bmoniey/dvox/docs/pics/IMG_2439.JPG

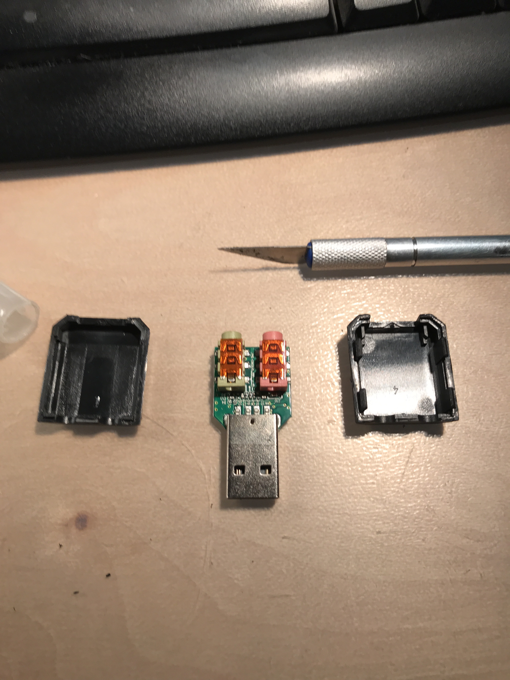
docs/pics/IMG_2439.JPG
