bmoniey/dvox/docs/pics/IMG_2547.JPG

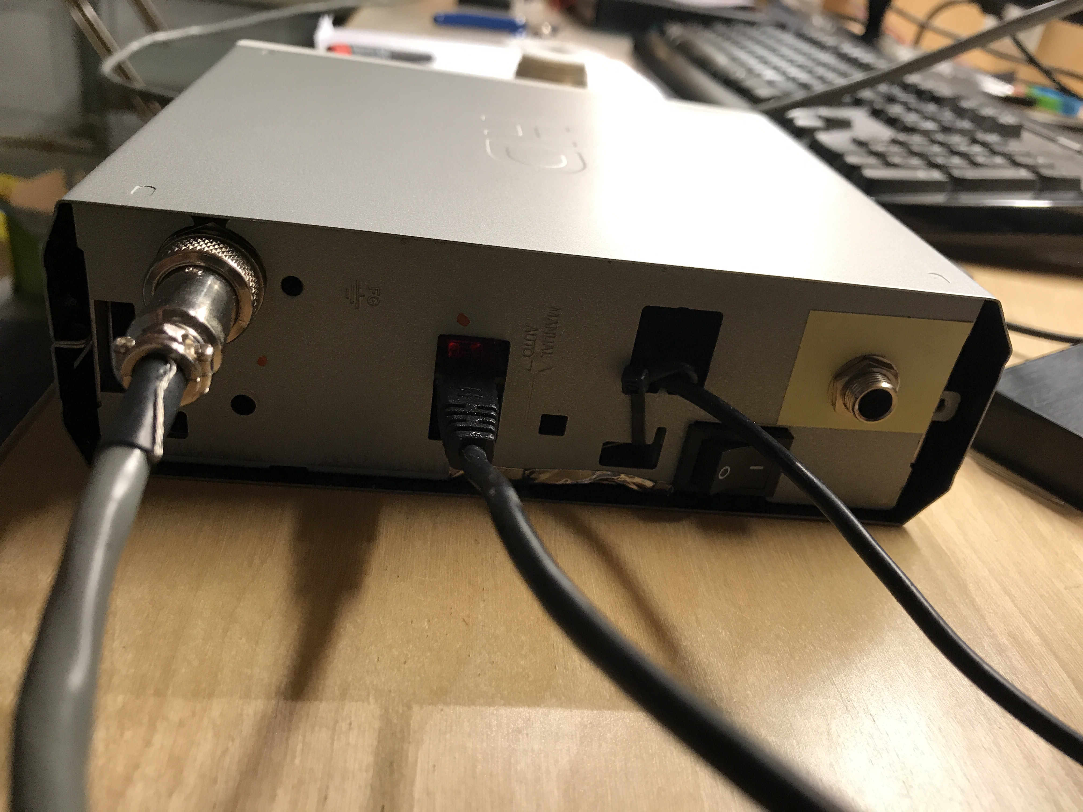
docs/pics/IMG_2547.JPG
