bmoniey/dvox/docs/pics/ft8 japan screen.jpg

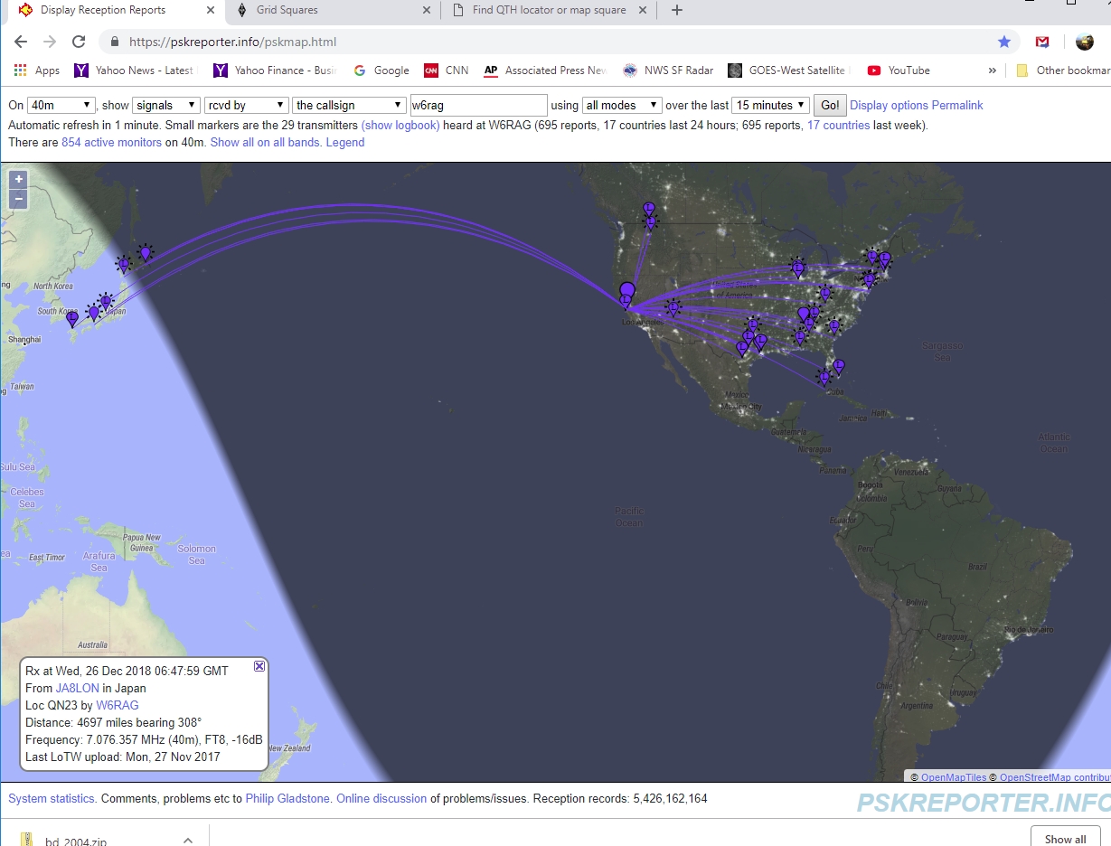
docs/pics/ft8 japan screen.jpg
