bmoniey/dvox/docs/pics/ft8 screen.jpg

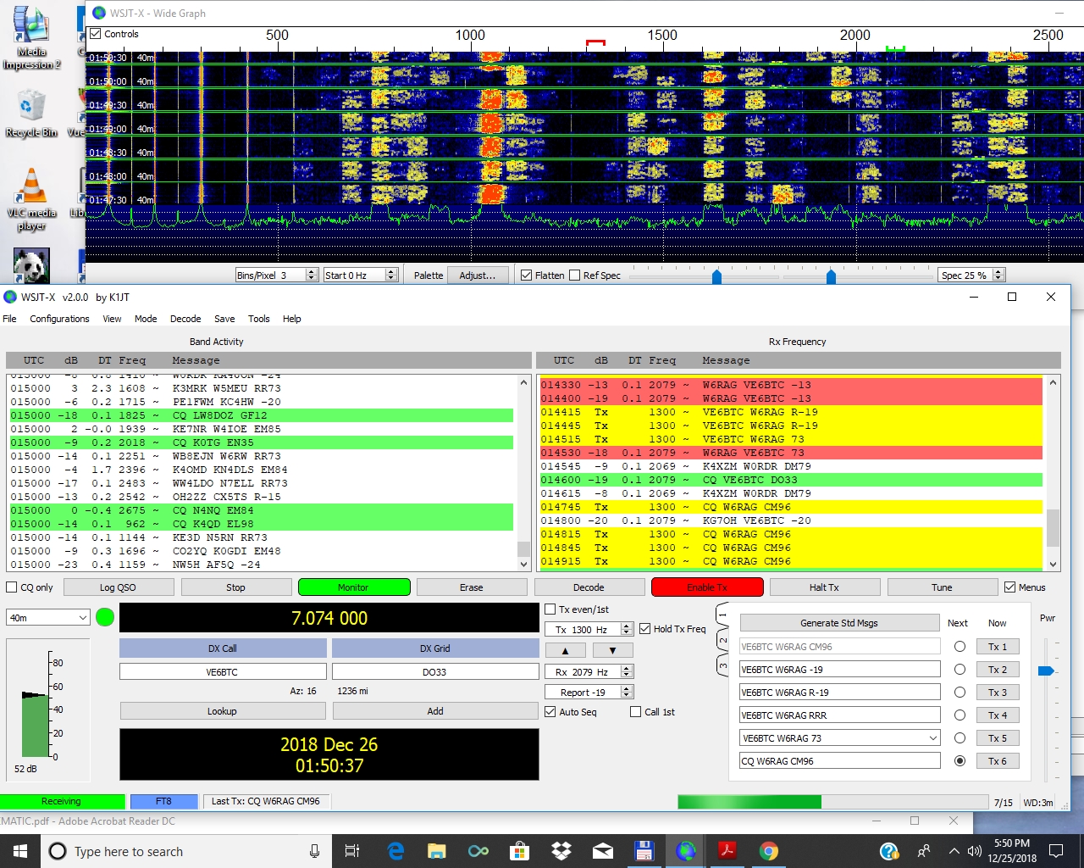
docs/pics/ft8 screen.jpg
