bmoniey/dvox/docs/pics/IMG_2438.JPG

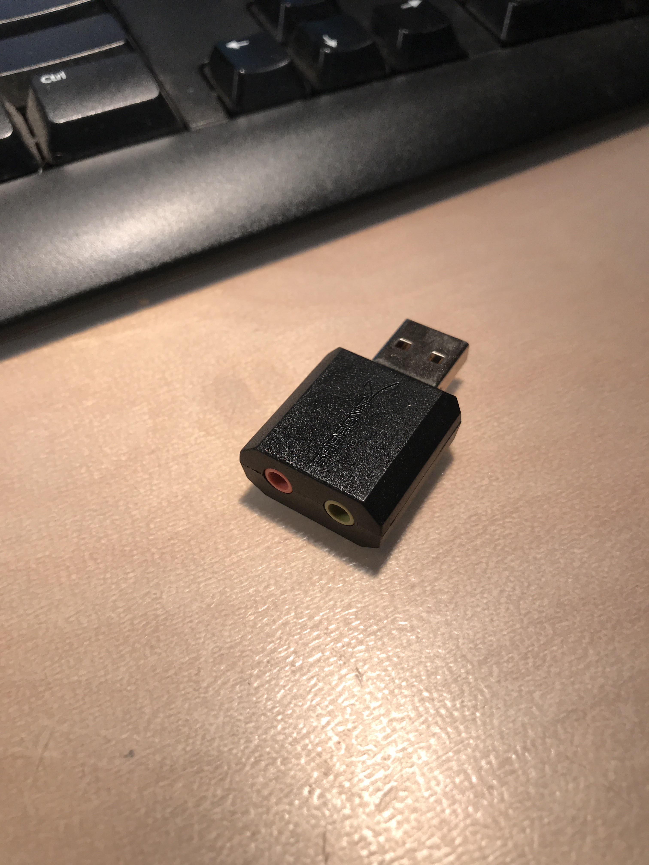
docs/pics/IMG_2438.JPG
