bmoniey/dvox/docs/pics/IMG_2440.JPG

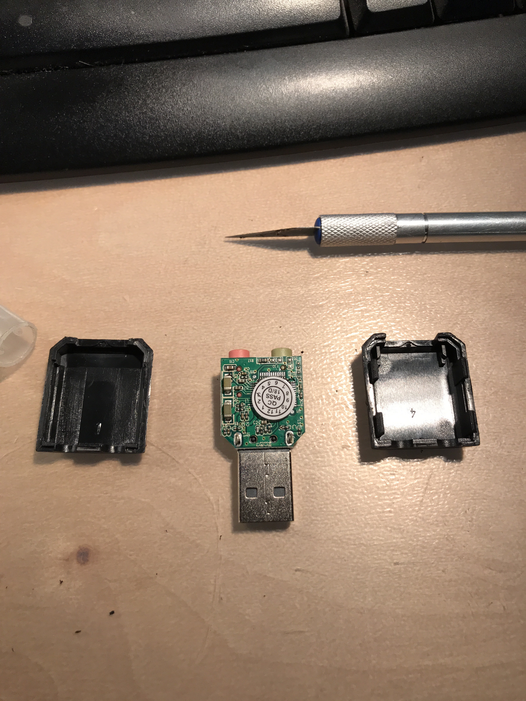
docs/pics/IMG_2440.JPG
