bmoniey/dvox/docs/pics/IMG_2538.JPG

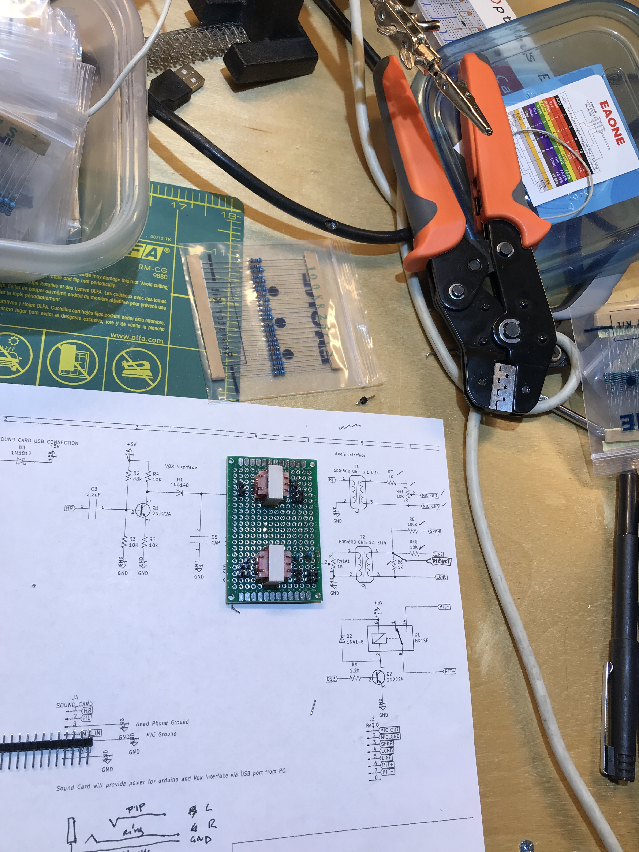
docs/pics/IMG_2538.JPG
