bmoniey/dvox/docs/pics/IMG_2539.JPG

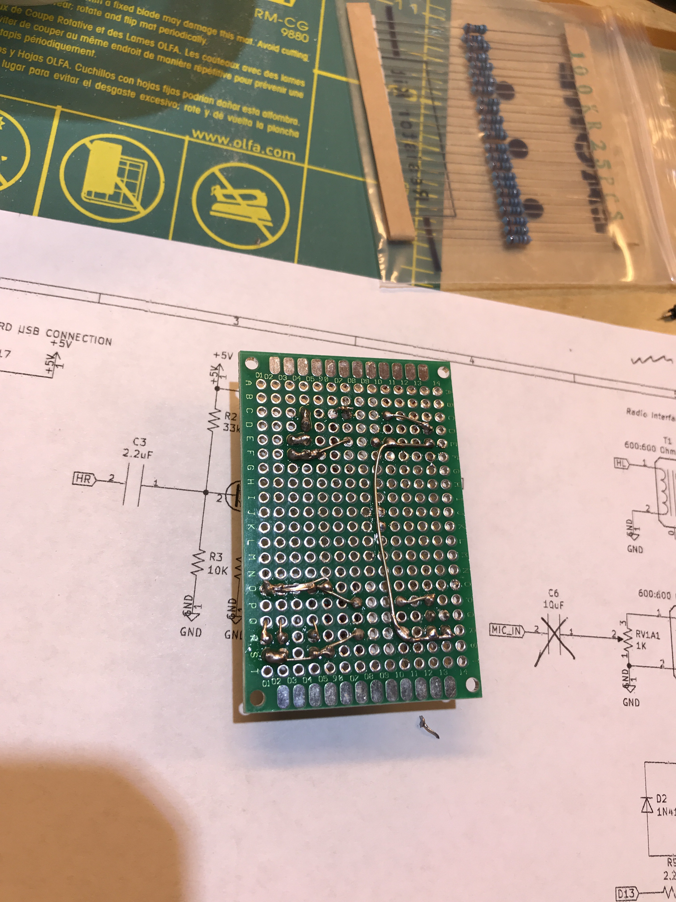
docs/pics/IMG_2539.JPG
