bmoniey/dvox/docs/pics/IMG_2540.JPG

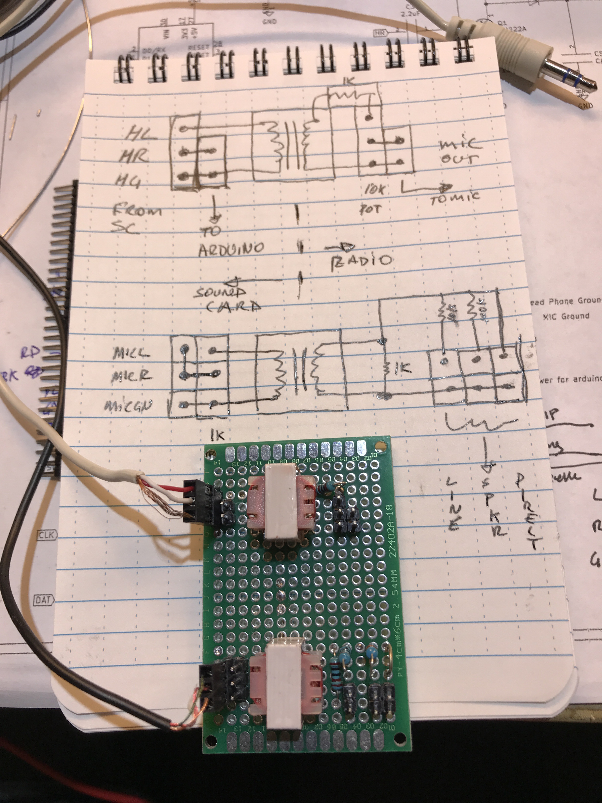
docs/pics/IMG_2540.JPG
