bmoniey/dvox/docs/pics/IMG_2546.JPG

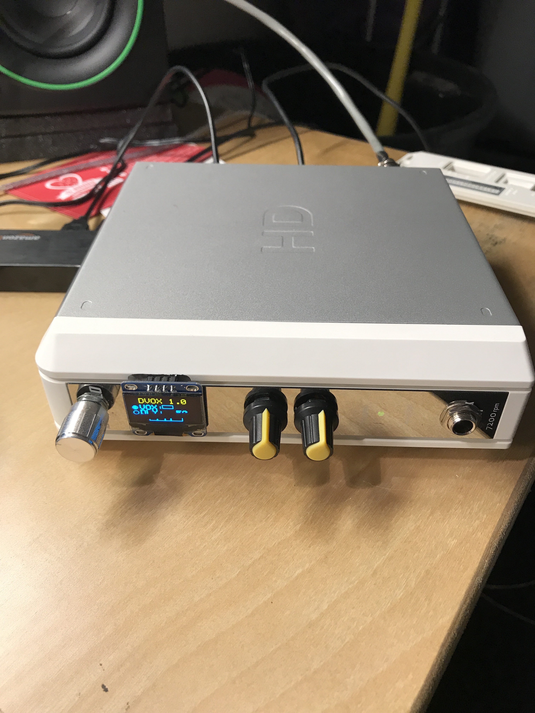
docs/pics/IMG_2546.JPG
