bmoniey/dvox/docs/pics/IMG_2548.JPG

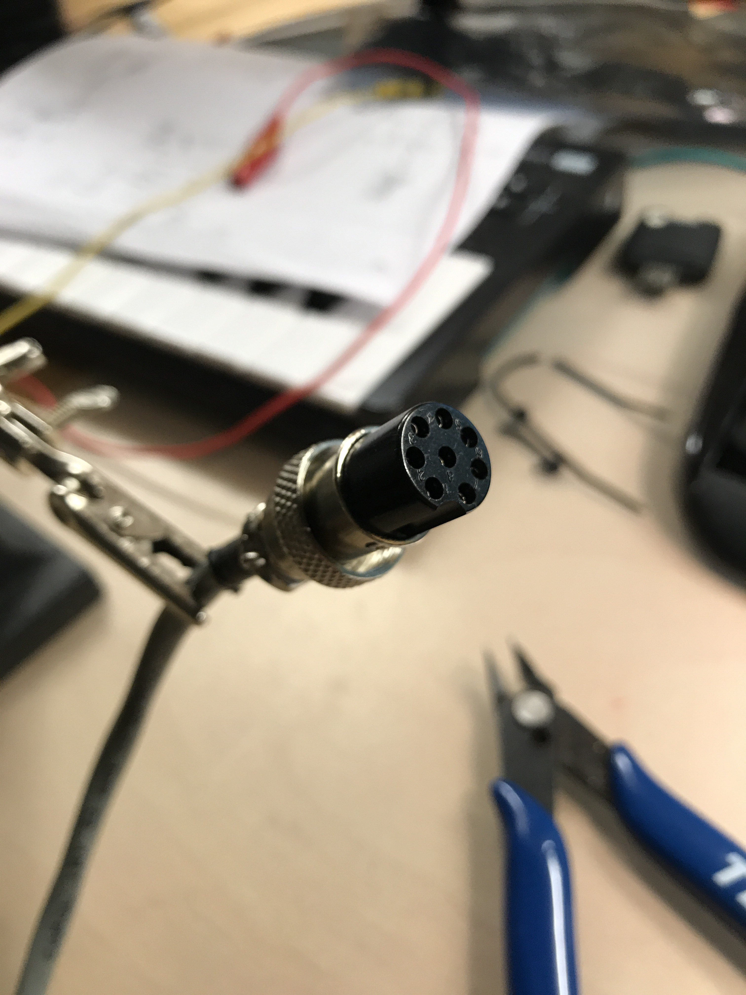
docs/pics/IMG_2548.JPG
