bmoniey/dvox/docs/pics/IMG_2549.JPG

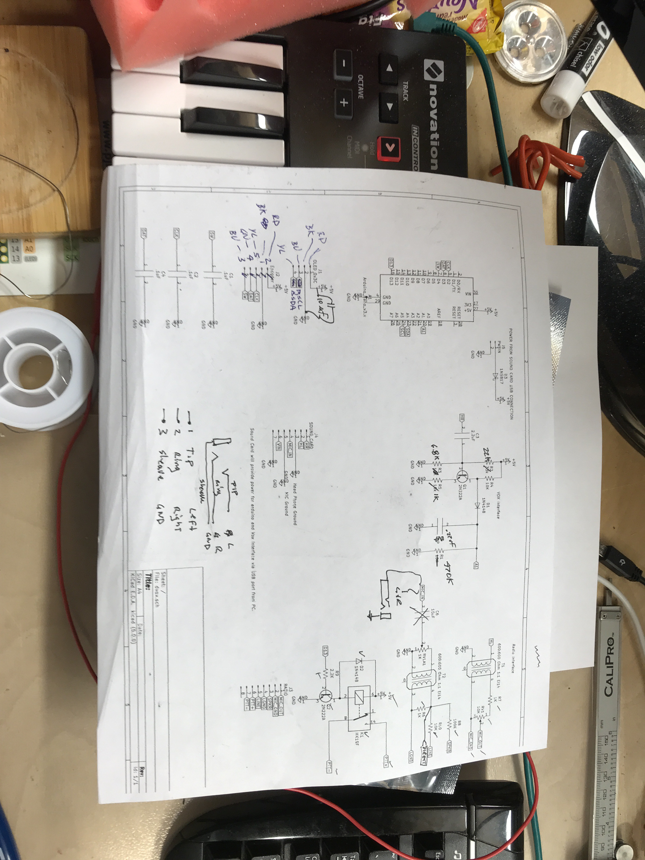
docs/pics/IMG_2549.JPG
