bmoniey/dvox/docs/pics/IMG_2567.JPG

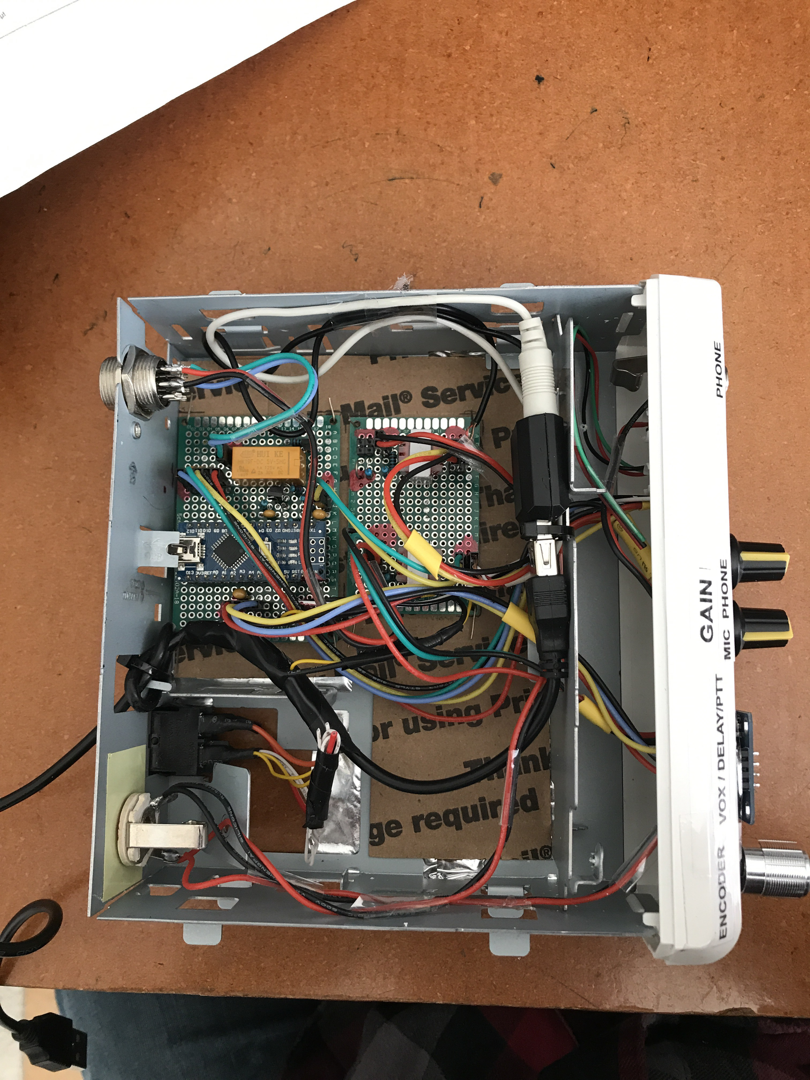
docs/pics/IMG_2567.JPG
