bmoniey/dvox/docs/pics/IMG_20181228_192853699.jpg

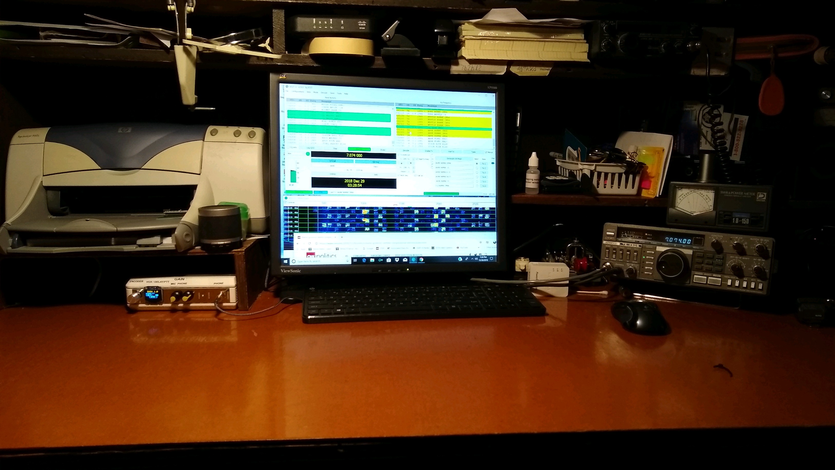
docs/pics/IMG_20181228_192853699.jpg
