bmoniey/dvox/docs/pics/n6nme ft8 Fiji.jpg

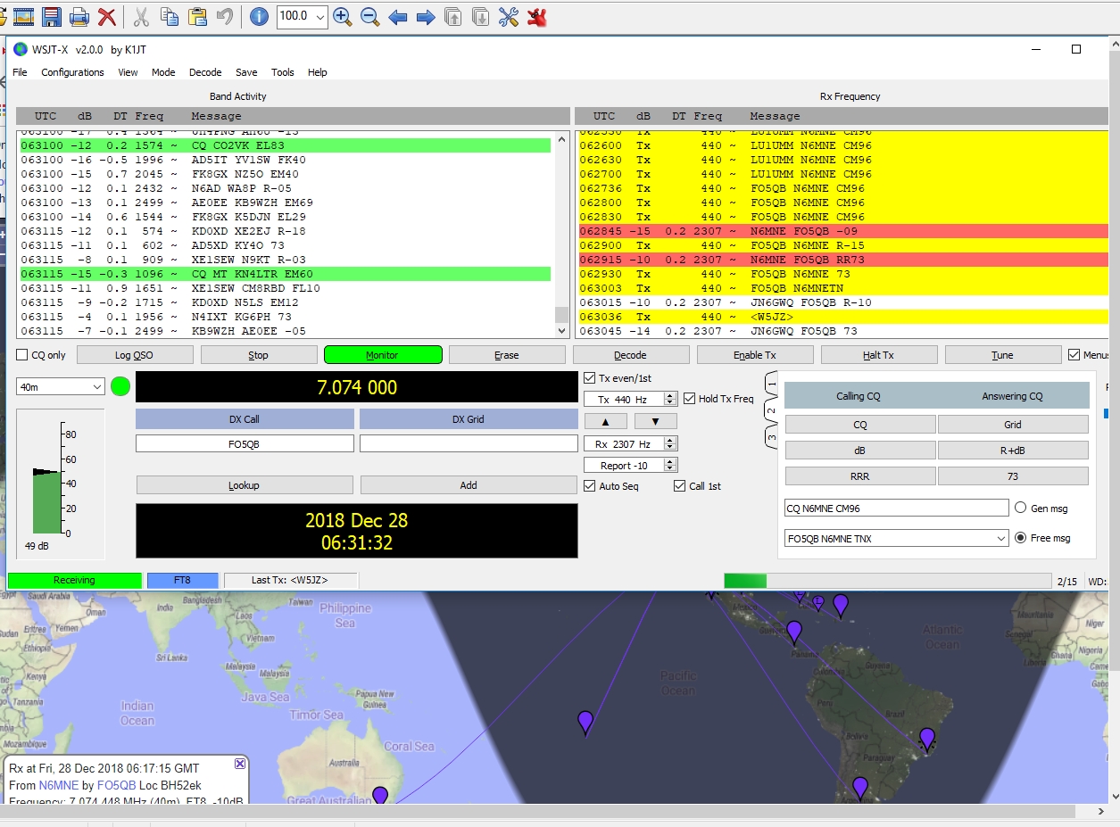
docs/pics/n6nme ft8 Fiji.jpg
