bmoniey/dvox/docs/pics/n6nme ft8.jpg

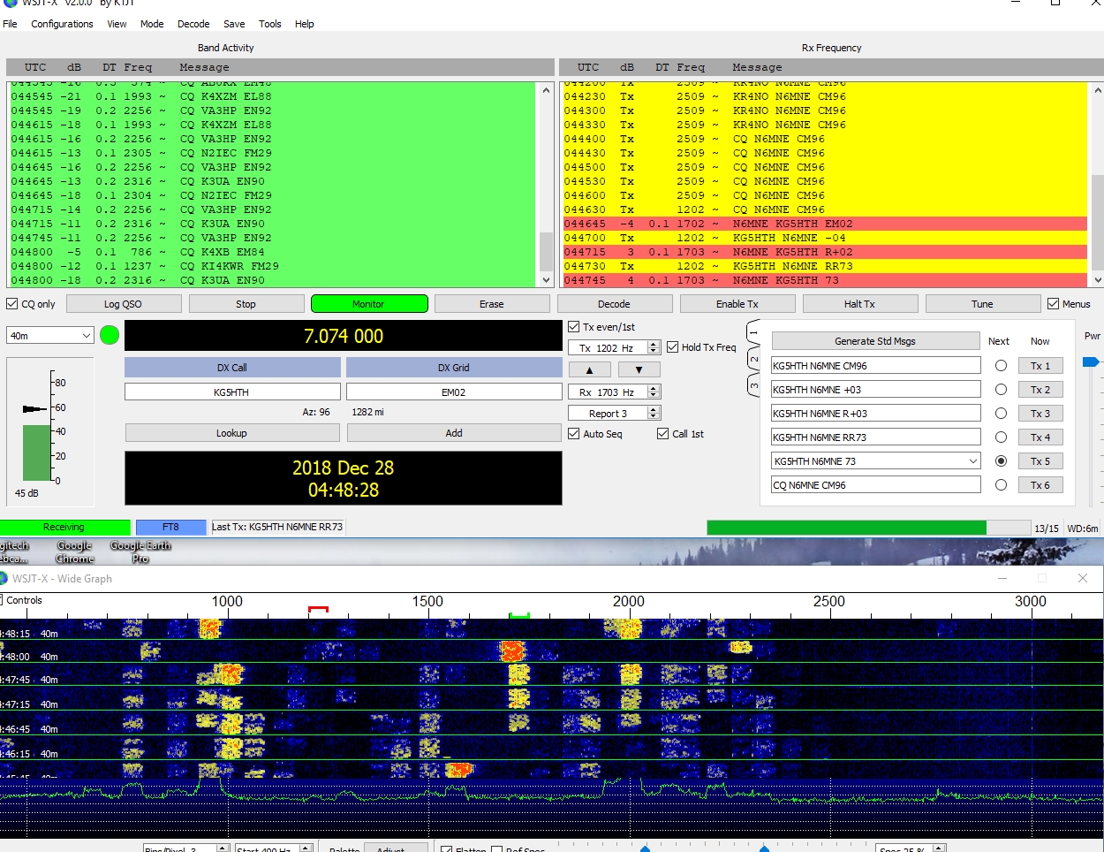
docs/pics/n6nme ft8.jpg
