bmoniey/dvox/docs/kicad/dvox/DVOX_SCHEMATIC.pdf

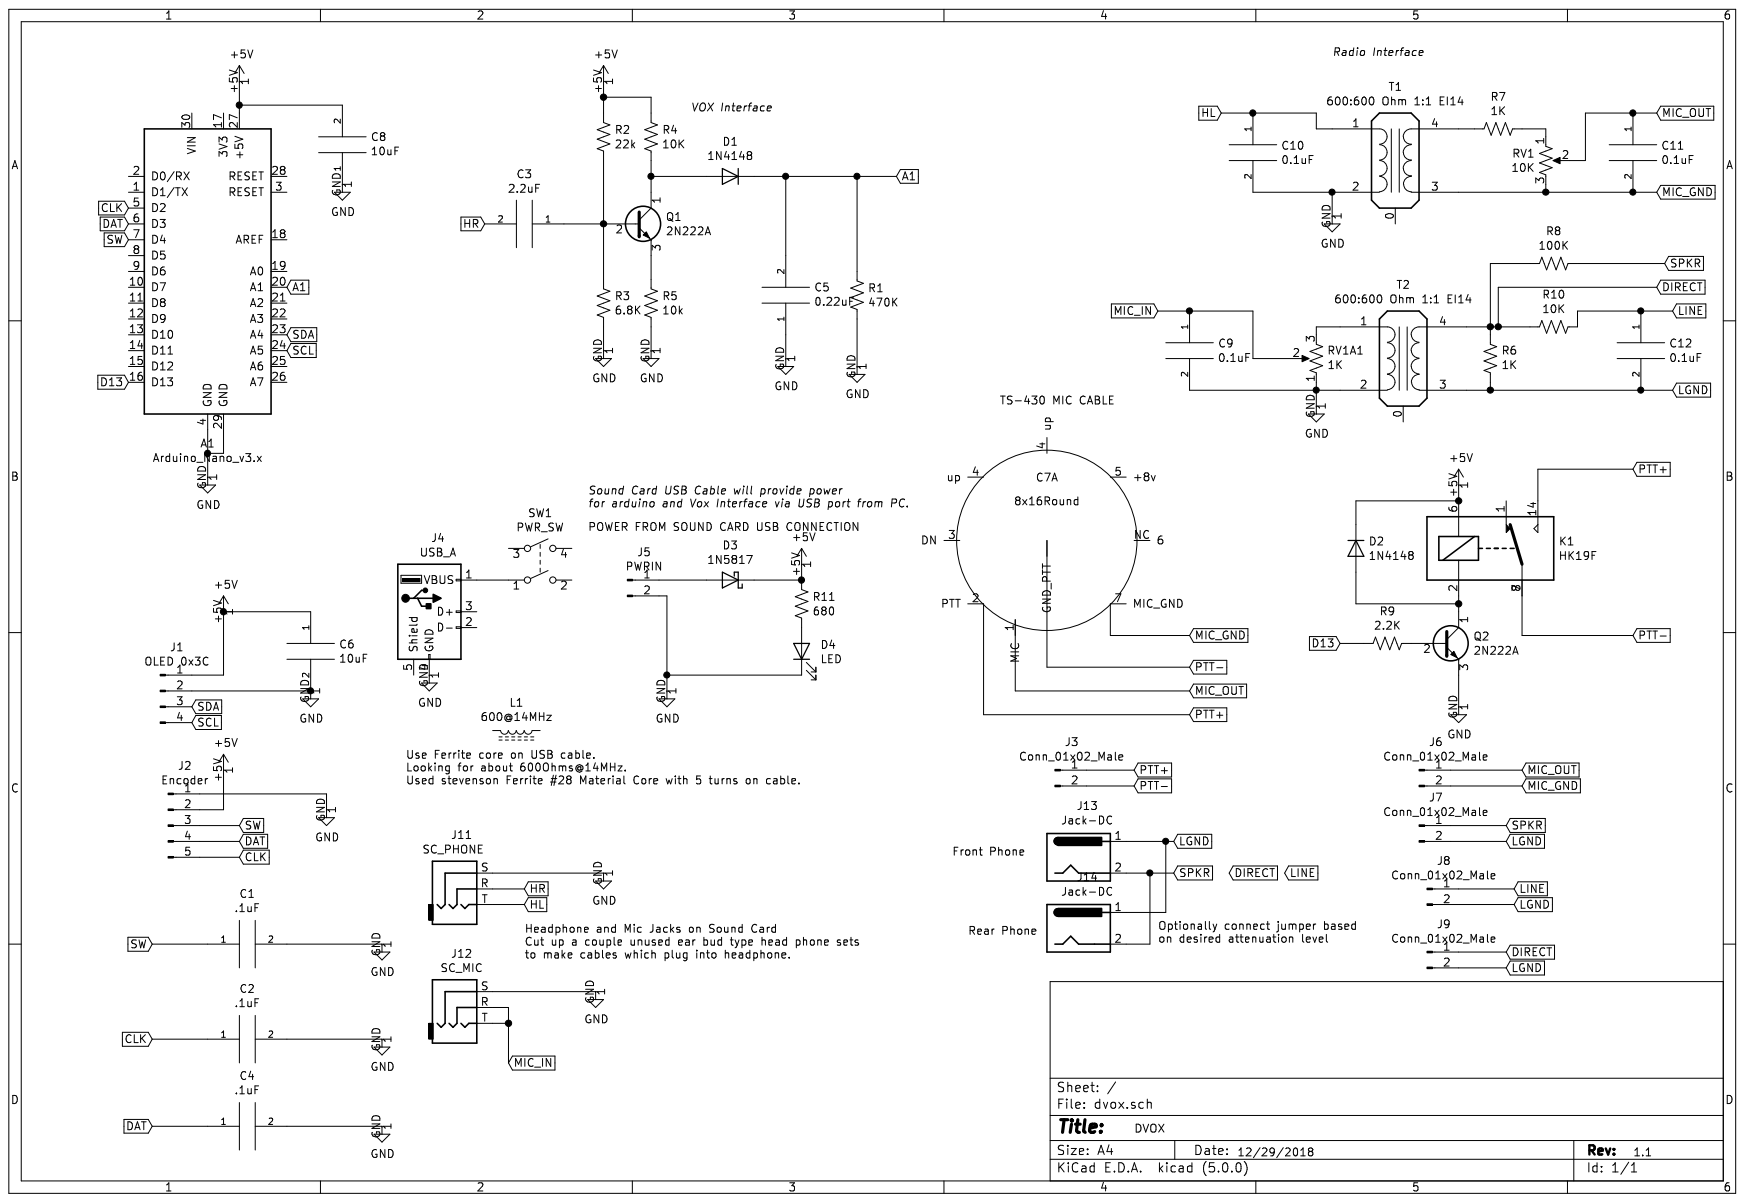
[picture p18: page 1]
