bmoniey/dvox/docs/block_diagram/dvox_block.pdf

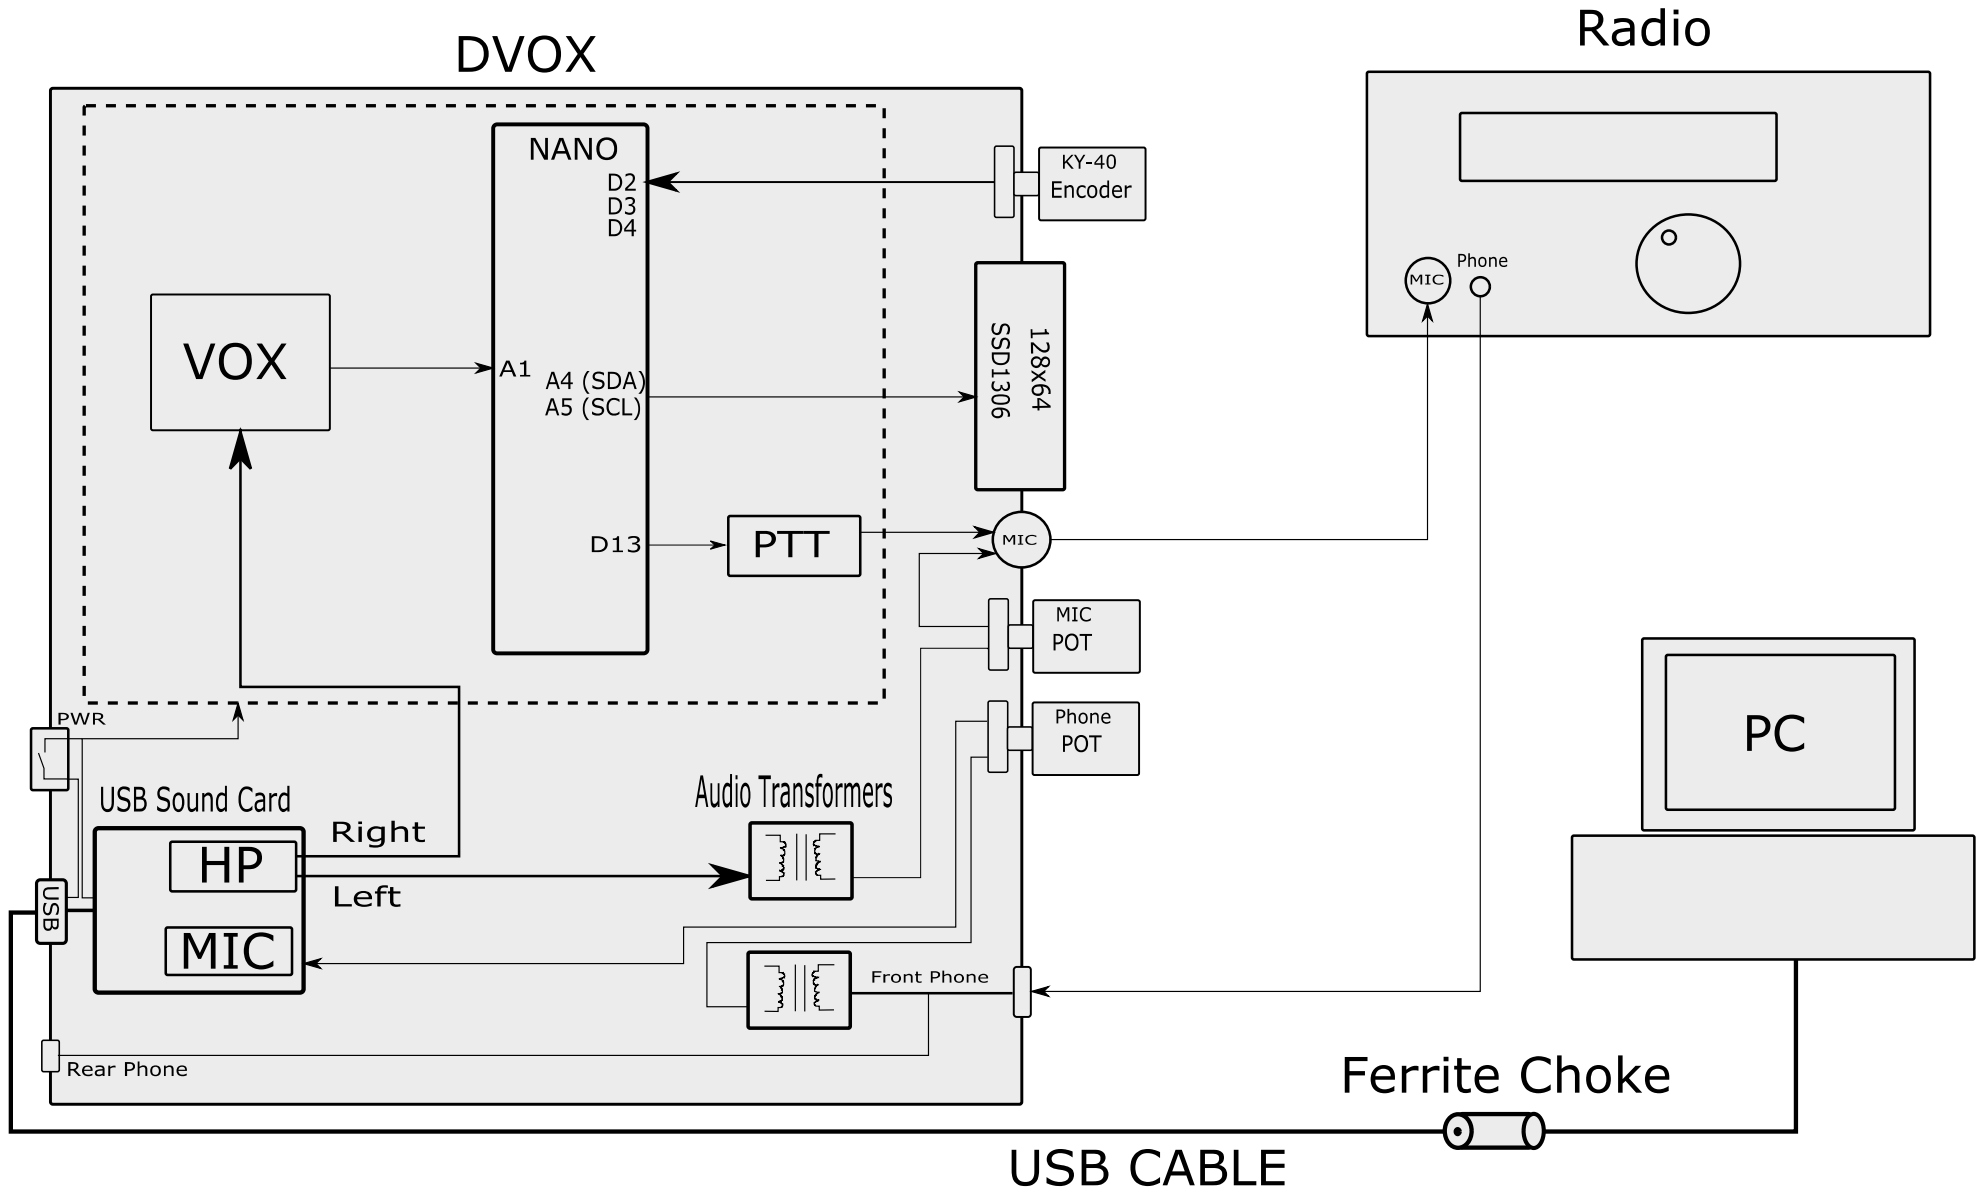
[picture p19: page 1]
