bmoniey/dvox/(commit log)

2018-12-20 first commit with files
    [dvox.kicad_pcb, dvox.sch]
2018-12-22 -Updated reame to give some cridit to Kevin Laughlin -Rotated pics -Created a bill of material
2018-12-22 Updated schematic Printed schematic to pdf for people without kicad\
    [dvox.sch]
2018-12-28 couple more operating pics
2018-12-30 Add a pic of the shack Updated Schematic with bypass caps and ferrite rf choke
    [dvox.sch]
2018-12-30 Added Block Diagram directory Created a block diragram in Inkscape (scg file) Printed block diagram to pdf
