bmoniey/dvox/docs/pics/IMG_2570.JPG

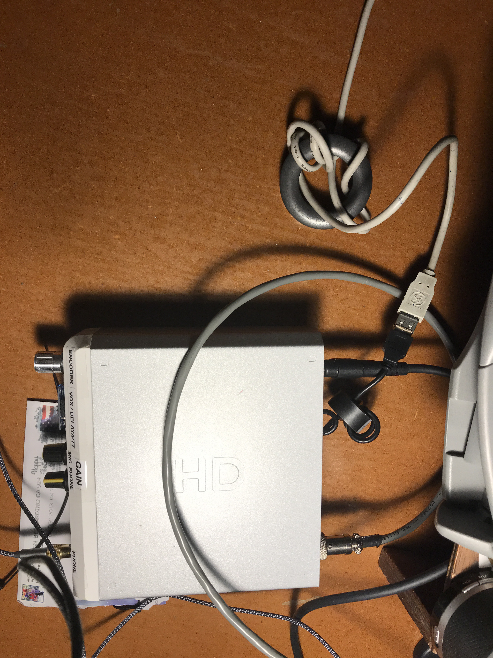
docs/pics/IMG_2570.JPG
